yurrrets/borjomi/Schematic2/borjomi_v2/borjomi_board_v2.kicad_pcb

## KiCad design Schematic2/borjomi_v2/borjomi_board_v2.kicad_pcb (2025-08-26)

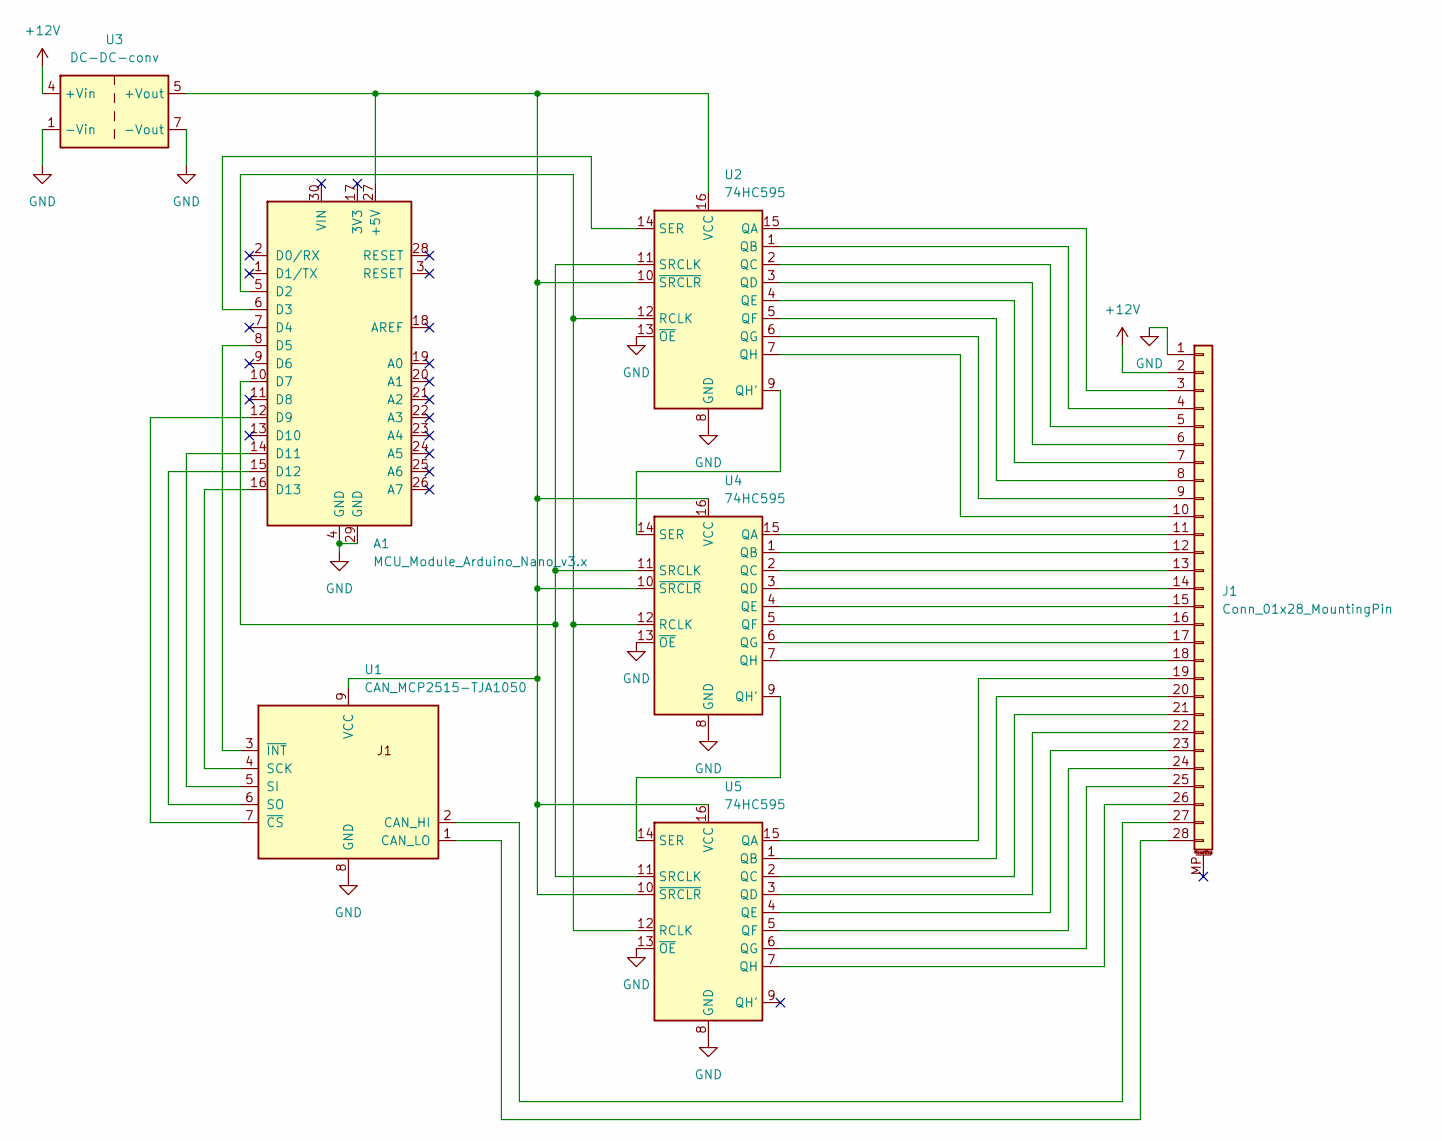
[picture p1: schematic borjomi_board_v2.kicad_sch]

Parts:
A1: MCU_Module_Arduino_Nano_v3.x; Arduino_Nano_Holes0.9
J1: Conn_01x28_MountingPin; PinHeader_1x28_P2.54mm_Vertical
U1: CAN_MCP2515-TJA1050; AOC346_MCP2515_Holes0.9
U2, U4, U5: 74HC595; DIP-16_W7.62mm
U3: DC-DC-conv; DC_DC_Step_Out

Connections:
+12V: J1.2, U3.4 (+Vin)
GND: A1.4 (GND), A1.29 (GND), J1.1, U1.8 (GND), U2.8 (GND), U2.13 (~OE), U3.1 (-Vin), U3.7 (-Vout), U4.8 (GND), U4.13 (~OE), U5.8 (GND), U5.13 (~OE)
unnamed: A1.27 (+5V), U1.9 (VCC), U2.10 (~SRCLR), U2.16 (VCC), U3.5 (+Vout), U4.10 (~SRCLR), U4.16 (VCC), U5.10 (~SRCLR), U5.16 (VCC)
unnamed: A1.5 (D2), U2.12 (RCLK), U4.12 (RCLK), U5.12 (RCLK)
unnamed: A1.6 (D3), U2.14 (SER)
unnamed: A1.8 (D5), U1.3 (~INT)
unnamed: A1.10 (D7), U2.11 (SRCLK), U4.11 (SRCLK), U5.11 (SRCLK)
unnamed: A1.12 (D9), U1.7 (~CS)
unnamed: A1.14 (D11), U1.5 (SI)
unnamed: A1.15 (D12), U1.6 (SO)
unnamed: A1.16 (D13), U1.4 (SCK)
unnamed: J1.3, U2.15 (QA)
unnamed: J1.4, U2.1 (QB)
unnamed: J1.5, U2.2 (QC)
unnamed: J1.6, U2.3 (QD)
unnamed: J1.7, U2.4 (QE)
unnamed: J1.8, U2.5 (QF)
unnamed: J1.9, U2.6 (QG)
unnamed: J1.10, U2.7 (QH)
unnamed: J1.11, U4.15 (QA)
unnamed: J1.12, U4.1 (QB)
unnamed: J1.13, U4.2 (QC)
unnamed: J1.14, U4.3 (QD)
unnamed: J1.15, U4.4 (QE)
unnamed: J1.16, U4.5 (QF)
unnamed: J1.17, U4.6 (QG)
unnamed: J1.18, U4.7 (QH)
unnamed: J1.19, U5.15 (QA)
unnamed: J1.20, U5.1 (QB)
unnamed: J1.21, U5.2 (QC)
unnamed: J1.22, U5.3 (QD)
unnamed: J1.23, U5.4 (QE)
unnamed: J1.24, U5.5 (QF)
unnamed: J1.25, U5.6 (QG)
unnamed: J1.26, U5.7 (QH)
unnamed: J1.27, U1.2 (CAN_HI)
unnamed: J1.28, U1.1 (CAN_LO)
unnamed: U2.9 (QH'), U4.14 (SER)
unnamed: U4.9 (QH'), U5.14 (SER)

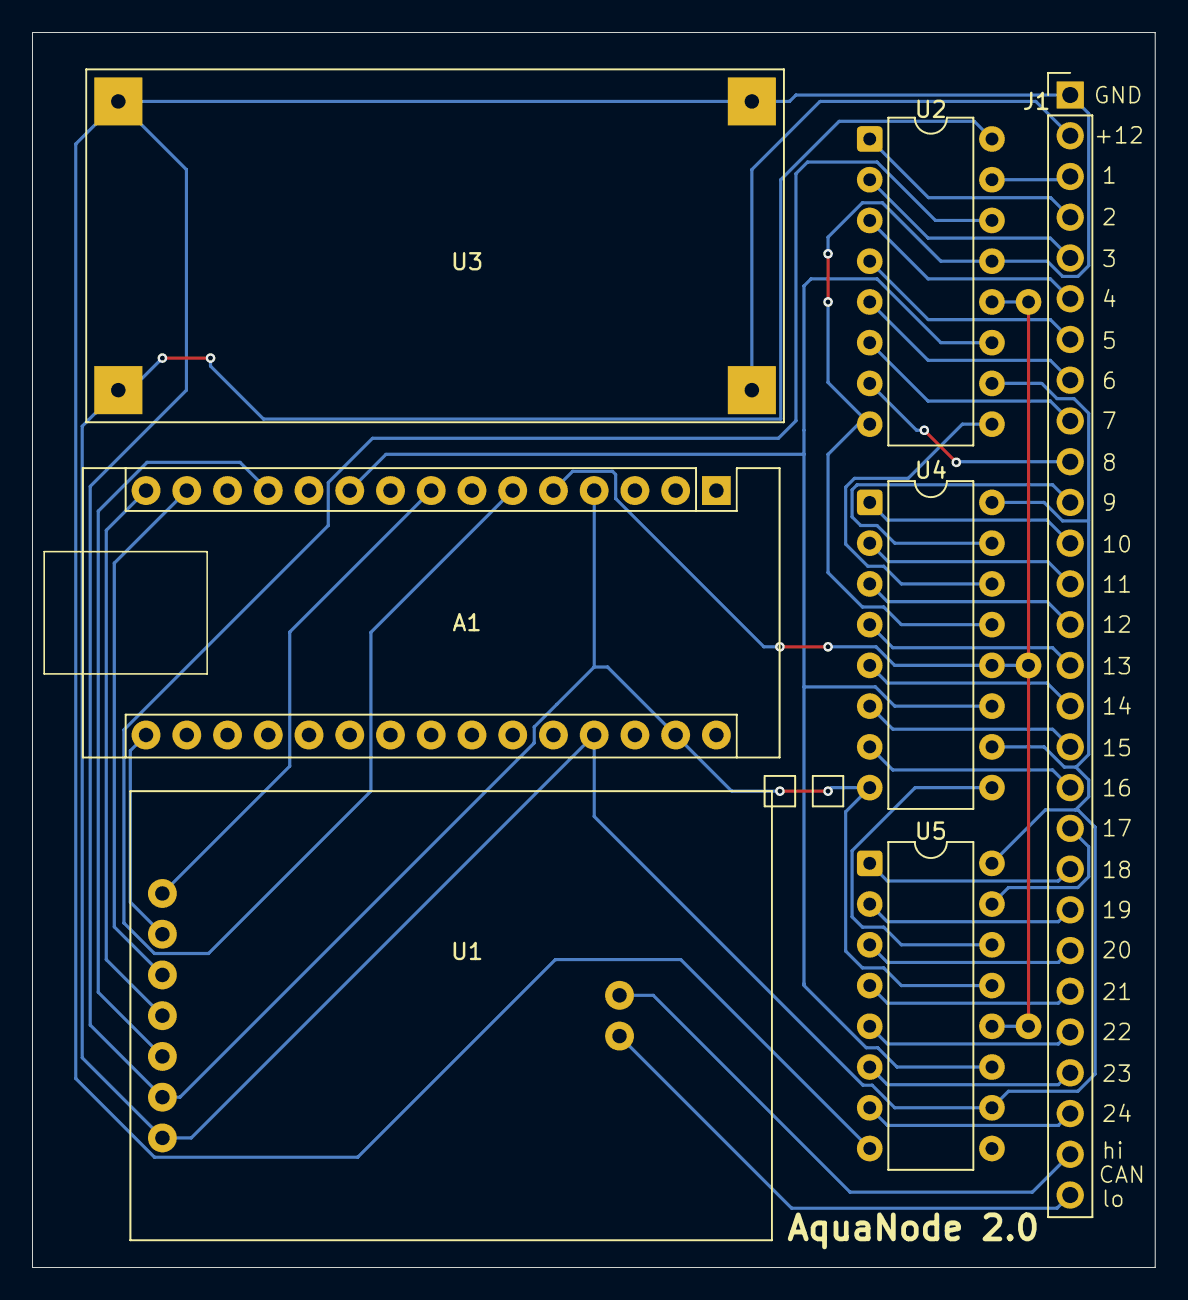
[picture p2: board borjomi_board_v2.kicad_pcb from above]

Board: 2 copper layers, 70.0 x 77.0 mm, 7 parts (0 on the bottom side), 39 nets.
