yurrrets/borjomi/Schematic/Borjomi-Main.kicad_pcb

## KiCad design Schematic/Borjomi-Main.kicad_pcb (2020-08-30)

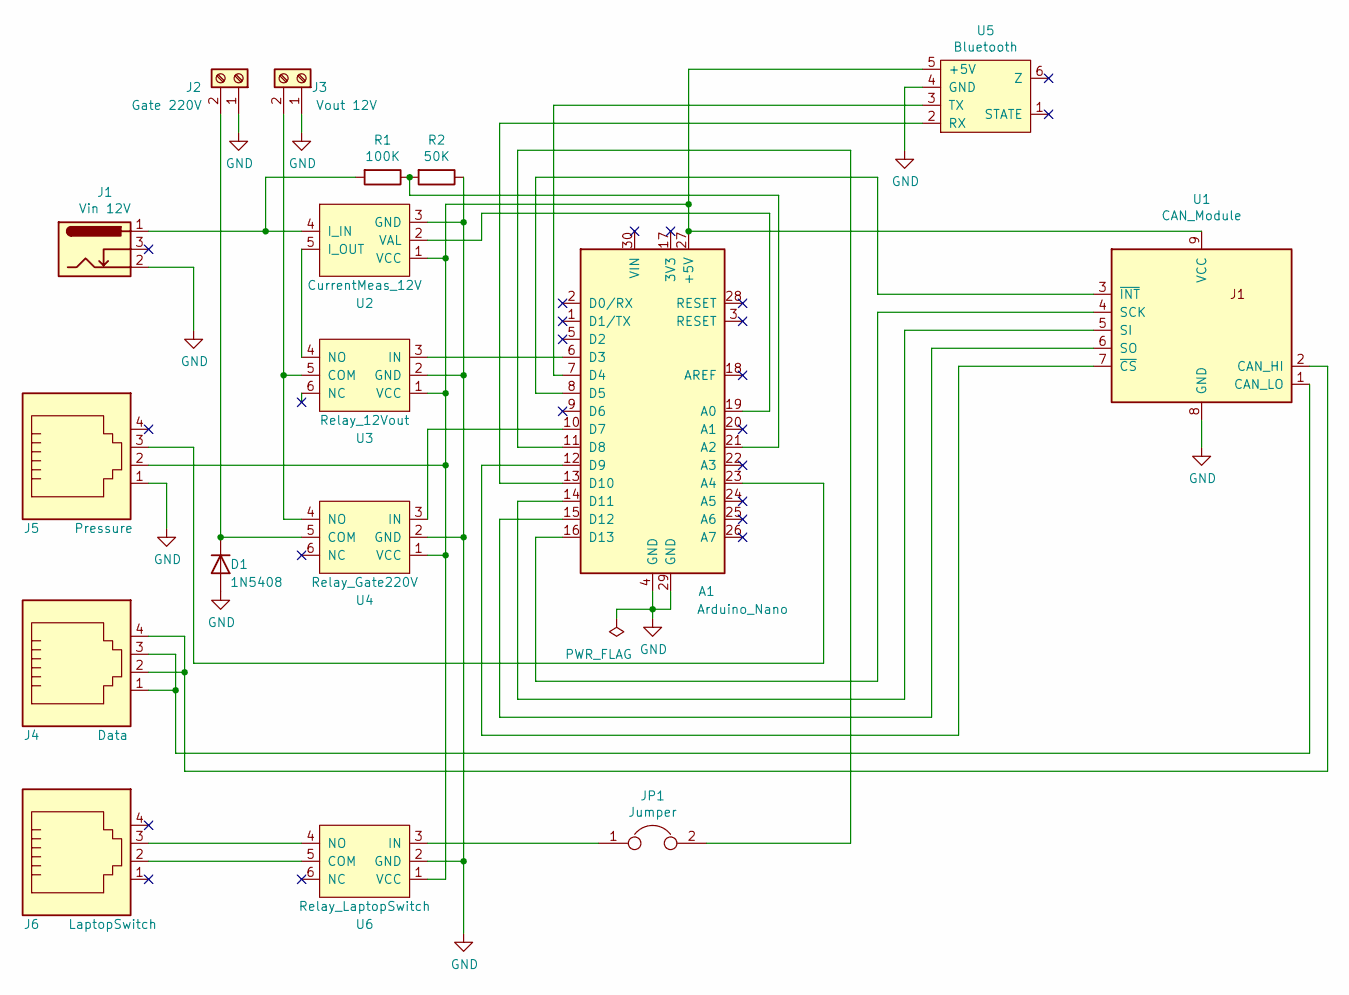
[picture p3: schematic Borjomi-Main.sch, My Scheme]

Parts:
A1: Arduino_Nano; Arduino_Nano_Holes0.9
D1: 1N5408; D_DO-27_P5.08mm_Vertical_KathodeUp
J1: Vin 12V; BarrelJack_Horizontal
J2: Gate 220V; Degson_DG301_1x02_P5.00mm_Horizontal
J3: Vout 12V; Degson_DG301_1x02_P5.00mm_Horizontal
J4: Data; RJ14_YH-57-21_5722_6P4C
J5: Pressure; RJ14_YH-57-21_5722_6P4C
J6: LaptopSwitch; RJ14_YH-57-21_5722_6P4C
JP1: Jumper; SimpleJumper_Pitch5.08mm_Drill0.7mm_2pad
R1: 100K; R_Box_L8.4mm_W2.5mm_P5.08mm
R2: 50K; R_Box_L8.4mm_W2.5mm_P5.08mm
U1: CAN_Module; AOC346_MCP2515_Holes0.9
U2: CurrentMeas_12V; ACS712
U3: Relay_12Vout; Relay_Module_1_Channel_Holes0.9
U4: Relay_Gate220V; Relay_Module_1_Channel_Holes0.9
U5: Bluetooth; HC-05
U6: Relay_LaptopSwitch; Relay_Module_1_Channel_Holes0.9

Connections:
GND: A1.4 (GND), A1.29 (GND), D1.2 (A), J1.2, J2.1, J3.1, J5.1, R2.1, U1.8 (GND), U2.3 (GND), U3.2 (GND), U4.2 (GND), U5.4 (GND), U6.2 (GND)
unnamed: A1.6 (D3), U3.3 (IN)
unnamed: A1.7 (D4), U5.3 (TX)
unnamed: A1.8 (D5), U1.3 (~INT)
unnamed: A1.10 (D7), U4.3 (IN)
unnamed: A1.11 (D8), JP1.2
unnamed: A1.12 (D9), U1.7 (~CS)
unnamed: A1.13 (D10), U5.2 (RX)
unnamed: A1.14 (D11), U1.5 (SI)
unnamed: A1.15 (D12), U1.6 (SO)
unnamed: A1.16 (D13), U1.4 (SCK)
unnamed: A1.19 (A0), U2.2 (VAL)
unnamed: A1.21 (A2), R1.1, R2.2
unnamed: A1.23 (A4), J5.3
unnamed: A1.27 (+5V), J5.2, U1.9 (VCC), U2.1 (VCC), U3.1 (VCC), U4.1 (VCC), U5.5 (+5V), U6.1 (VCC)
unnamed: D1.1 (K), J2.2, U4.5 (COM)
unnamed: J1.1, R1.2, U2.4 (I_IN)
unnamed: J3.2, U3.5 (COM), U4.4 (NO)
unnamed: J4.1, J4.3, U1.1 (CAN_LO)
unnamed: J4.2, J4.4, U1.2 (CAN_HI)
unnamed: J6.2, U6.5 (COM)
unnamed: J6.3, U6.4 (NO)
unnamed: JP1.1, U6.3 (IN)
unnamed: U2.5 (I_OUT), U3.4 (NO)

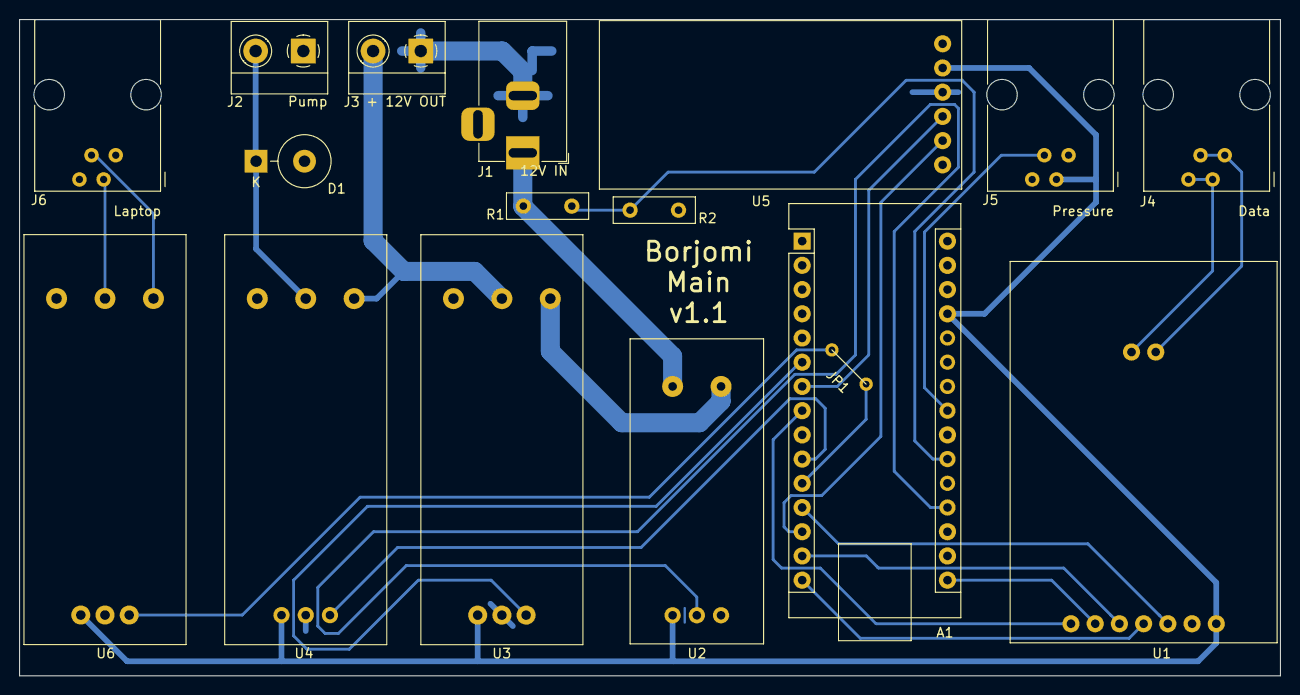
[picture p4: board Borjomi-Main.kicad_pcb from above]

Board: 2 copper layers, 132.3 x 68.8 mm, 17 parts (0 on the bottom side), 24 nets.
