yurrrets/borjomi/Schematic/Borjomi.kicad_pcb

## KiCad design Schematic/Borjomi.kicad_pcb (2019-04-21)

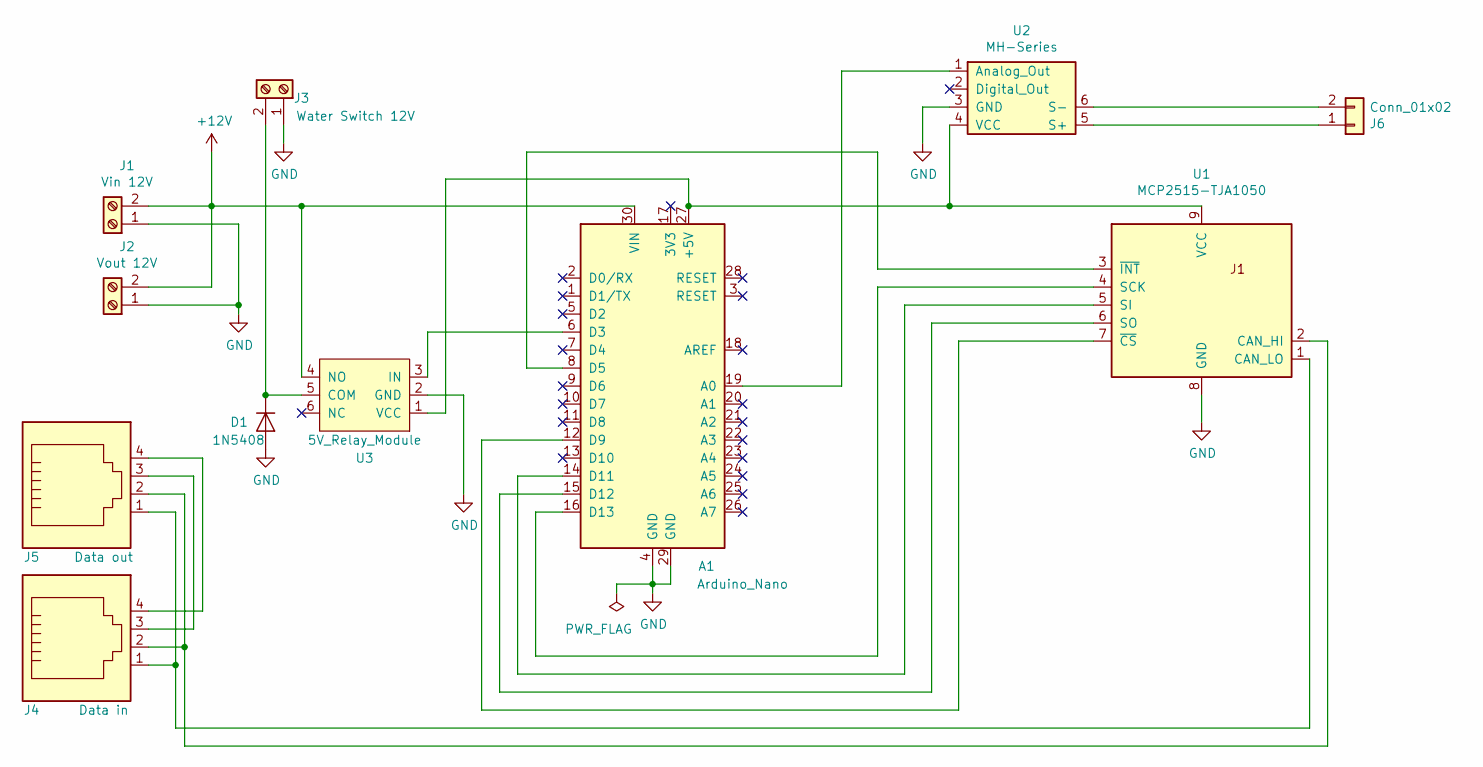
[picture p5: schematic Borjomi.sch, My Scheme]

Parts:
A1: Arduino_Nano; Arduino_Nano_Holes0.9
D1: 1N5408; D_DO-27_P5.08mm_Vertical_KathodeUp
J1: Vin 12V; Degson_DG301_1x02_P5.00mm_Horizontal
J2: Vout 12V; Degson_DG301_1x02_P5.00mm_Horizontal
J3: Water Switch 12V; Degson_DG301_1x02_P5.00mm_Horizontal
J4: Data in; RJ14_YH-57-21_5722_6P4C
J5: Data out; RJ14_YH-57-21_5722_6P4C
J6: Conn_01x02; Degson_DG301_1x02_P5.00mm_Horizontal
U1: MCP2515-TJA1050; AOC346_MCP2515_Holes0.9
U2: MH-Series; MH_Sensor_Holes0.9
U3: 5V_Relay_Module; Relay_Module_1_Channel_Holes0.9

Connections:
+12V: A1.30 (VIN), J1.2, J2.2, U3.4 (NO)
GND: A1.4 (GND), A1.29 (GND), D1.2 (A), J1.1, J2.1, J3.1, U1.8 (GND), U2.3 (GND), U3.2 (GND)
unnamed: A1.6 (D3), U3.3 (IN)
unnamed: A1.8 (D5), U1.3 (~INT)
unnamed: A1.12 (D9), U1.7 (~CS)
unnamed: A1.14 (D11), U1.5 (SI)
unnamed: A1.15 (D12), U1.6 (SO)
unnamed: A1.16 (D13), U1.4 (SCK)
unnamed: A1.19 (A0), U2.1 (Analog_Out)
unnamed: A1.27 (+5V), U1.9 (VCC), U2.4 (VCC), U3.1 (VCC)
unnamed: D1.1 (K), J3.2, U3.5 (COM)
unnamed: J4.1, J5.1, U1.1 (CAN_LO)
unnamed: J4.2, J5.2, U1.2 (CAN_HI)
unnamed: J4.3, J5.3
unnamed: J4.4, J5.4
unnamed: J6.1, U2.5 (S+)
unnamed: J6.2, U2.6 (S-)

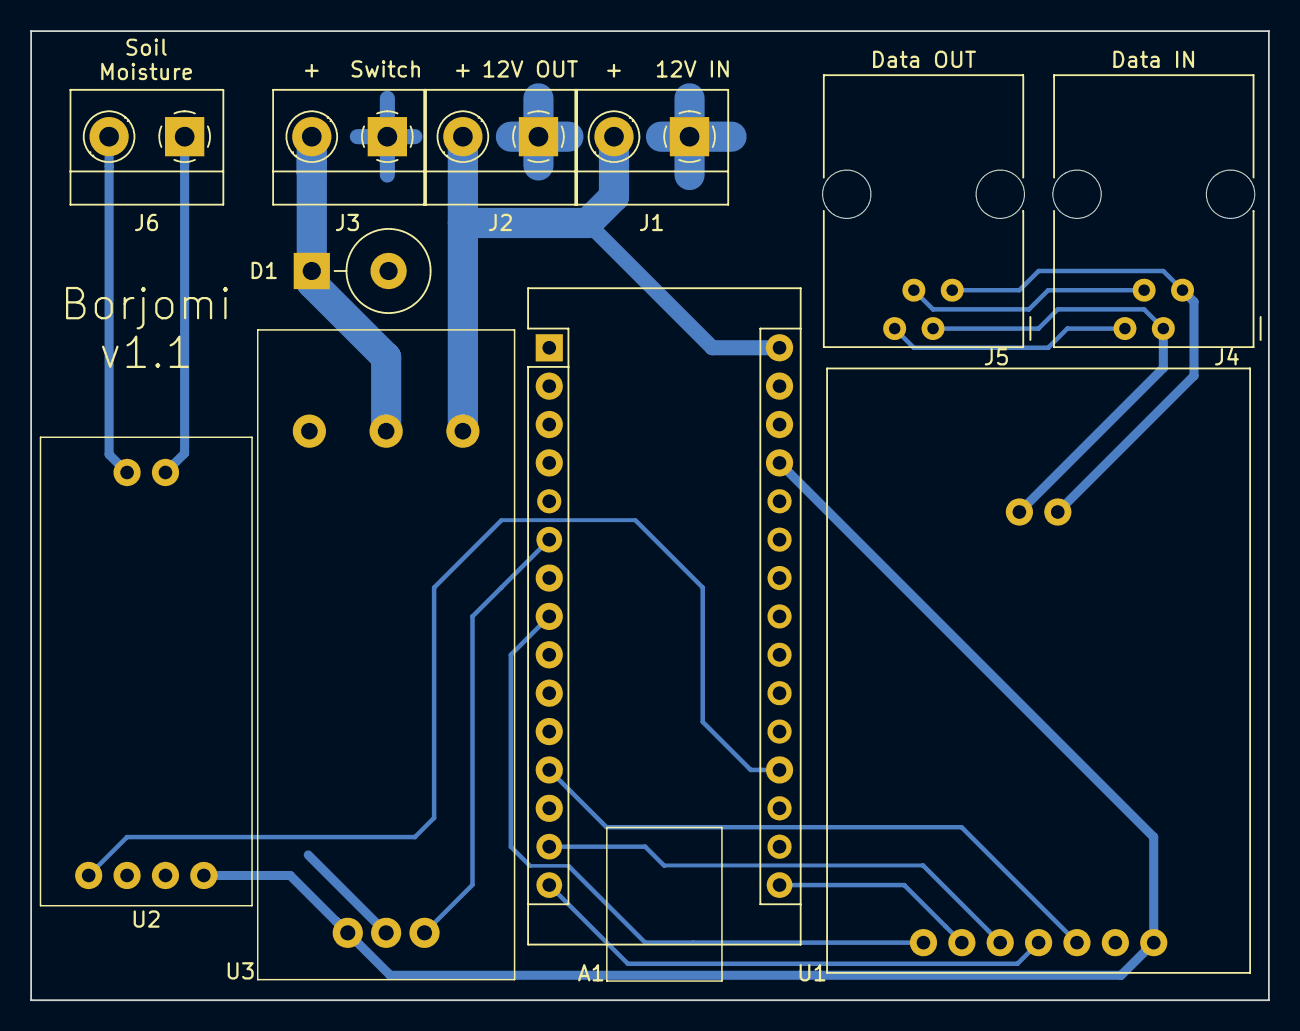
[picture p6: board Borjomi.kicad_pcb from above]

Board: 2 copper layers, 81.9 x 64.1 mm, 11 parts (0 on the bottom side), 17 nets.
