yurrrets/borjomi/Arduino/sources/common-node/src/cmd_codes.h

// Message format (8-byte message)
//   ByteNo     Description
//   0          CRC8 of next 7 bytes
//   1          Command No
//   2          Command code CMD_XXX
//   3          Command device num (pin num or ordinal device num [water switch num, soil moisture num, etc.)
//   4-7        Value


#define CMD_INVALID              (0)
#define CMD_ERROR                (0xFF)

#define CVAL_ERR_NO_ERROR        (0)
#define CVAL_ERR_INVALID_DEV_NO  (1)

/// This is the answer for most commands (except PING).
/// Keep CommandNo and CommandDevNo.
/// Value in answer depends on command type.
/// For CMD_SET_XXX is usually CVAL_ACCEPTED
#define CMD_OK                   (1)
#define CVAL_ACCEPTED            (0)

/// When send to node 0x0 (MULTICAST_NODE), this means multicast message.
/// And every slave node in this case should answer with CMD_PONG.
/// Otherwise react only if node address matches, as always.
#define CMD_PING                 (2)

/// This is the answer to ping command (CMD_PING)
/// Value of command answer is slave node's address.
#define CMD_PONG                 (3)

/// Sets state of water switch.
/// Value could be CVAL_CLOSED or CVAL_OPENED
/// Command device num is ordinal number, 0...(count(PINS_WATER_SWITCH)-1)
#define CMD_SET_WATER_SWITCH     (4)
#define CVAL_CLOSED              (0)
#define CVAL_OPENED              (1)

/// Gets current state of water switch.
/// Returned value is CVAL_CLOSED or CVAL_OPENED
/// Command device num is ordinal number, 0...(count(PINS_WATER_SWITCH)-1)
#define CMD_GET_WATER_SWITCH     (5)
//#define CVAL_CLOSING             (3)
//#define CVAL_OPENING             (4)

/// Reads soil moisture value, in range 0..1024
/// Value is relative, bigger values means that moisture is bigger.
/// Command device num is ordinal number, 0...(count(PINS_SOIL_MOISTURE)-1)
#define CMD_READ_SOIL_MOISTURE   (6)

/// Returns current version of firmware.
/// Answer is CMD_OK, and value is in format <major>.<minor>.<rev>
/// Highest 8 bits of value is <major>, next 8 bits are for <minor>, and lowest 16 bits are for <rev>
#define CMD_VERSION              (7)
#define MAKE_VERSION(mj,mn,rev)  ((((uint32_t)mj & 0xFF) << 24) | (((uint32_t)mn & 0xFF) << 16) | ((uint32_t)rev & 0xFFFF))

/// Returns capabilities of the node.
/// Answer is CMD_OK.
/// Value consist of 8 group by 4 bits.
/// Every group correspond to one of CB_XXX const.
/// Rule: CB_WATER_SWITCH == 1, and group is first 4 bits.
/// CB_SOIL_MOISTURE == 2, and group is second 4 bits. And so on.
#define CMD_CAPABILITIES         (8)

/// Reads current pressure in the system in mAtm (milli atmosphere)
/// Command device num is ordinal number, 0...(count(PINS_PRESSURE_SENSOR)-1)
#define CMD_READ_PRESSURE_SENSOR     (10)

/// Returns DC current in 12V line, in mA
/// Command device num is ordinal number, 0...(count(PINS_CURRENT_SENSOR)-1)
#define CMD_READ_CURRENT_SENSOR      (11)

/// Sets state of DC 12V line switch.
/// Value could be CVAL_OFF or CVAL_ON
/// Command device num is ordinal number, 0...(count(PINS_DC_ADAPTER_SWITCH)-1)
#define CMD_SET_DC_ADAPTER_SWITCH    (12)
#define CVAL_OFF                     (0)
#define CVAL_ON                      (1)

/// Gets current state of DC 12V line switch.
/// Returned value is CVAL_OFF or CVAL_ON
/// Command device num is ordinal number, 0...(count(PINS_DC_ADAPTER_SWITCH)-1)
#define CMD_GET_DC_ADAPTER_SWITCH    (13)

/// Returns DC voltage in 12V line, in mV
/// Command device num is ordinal number, 0...(count(PINS_VOLTAGE_SENSOR)-1)
#define CMD_READ_VOLTAGE_SENSOR      (14)

/// Sets state of pump switch.
/// Note that pump gets worked you also should set to on DC_ADAPTER_SWITCH
/// Value could be CVAL_OFF or CVAL_ON
/// Command device num is ordinal number, 0...(count(PINS_PUMP_SWITCH)-1)
#define CMD_SET_PUMP_SWITCH          (15)

/// Gets current state of pump switch.
/// Returned value is CVAL_OFF or CVAL_ON
/// Note that this value could be CVAL_ON but this doesn't mean that pump is working;
/// pump is working when both CMD_GET_PUMP_SWITCH and CMD_GET_DC_ADAPTER_SWITCH are CVAL_ON
/// Command device num is ordinal number, 0...(count(PINS_PUMP_SWITCH)-1)
#define CMD_GET_PUMP_SWITCH          (16)

#define CMD_SET_MAIN_SCENARIO        (17)
#define CMD_GET_MAIN_SCENARIO        (18)



/// Next functions should be used carefully.
/// Remember that function do not perform any checks.
/// However, pins 0,1 are usually used as RX,TX pin on built-in COM port.
/// Pins 2,9,11,12,13 are used for SPI bus for CAN module.
/// Pin 3 is used for Water Switch.
/// Avoid using this pins directly with next functions.


/// Calls analogWrite Arduino function. Uses commandPin part of message.
/// Answers with CMD_OK, value equals to value parameter of input messge.
#define CMD_ANALOG_WRITE         (32)

/// Reads the value of analog input pin. Uses commandPin part of message.
/// Just calls analogRead Arduino function, and return the value.
#define CMD_ANALOG_READ          (33)

/// Calls digitalWrite Arduino function. Uses commandPin part of message.
/// Answers with CMD_OK, value equals to value parameter of input messge.
#define CMD_DIGITAL_WRITE        (34)

/// Calls digitalRead Arduino function. Uses commandPin part of message.
/// Answers with CMD_OK, value equals to result of digitalRead call.
#define CMD_DIGITAL_READ         (35)

/// Calls pinMode Arduino function. Uses commandPin part of message.
/// Answers with CMD_OK, value equals to CVAL_ACCEPTED.
#define CMD_DIGITAL_PIN_MODE     (36)
