yurrrets/borjomi/Arduino/tests/arduino-mock/Arduino.h

#pragma once

#include <cstdint>
#include "HardwareSerial.h"

#define HIGH 0x1
#define LOW  0x0

#define INPUT 0x0
#define OUTPUT 0x1
#define INPUT_PULLUP 0x2

#define F(str) str

typedef uint8_t byte;

unsigned long millis(void);
unsigned long micros(void);
void delay(unsigned long ms);
void delayMicroseconds(unsigned int us);

void pinMode(uint8_t pin, uint8_t mode);
void digitalWrite(uint8_t pin, uint8_t val);
int digitalRead(uint8_t pin);
int analogRead(uint8_t pin);
void analogReference(uint8_t mode);
void analogWrite(uint8_t pin, int val);
