yurrrets/borjomi/Arduino/tests/arduino-mock/TemplateTools.h

template <class... Args>
struct template_concat;

template <template <class...> class T, class... Args1, class... Args2, typename... Remaining>
struct template_concat<T<Args1...>, T<Args2...>, Remaining...> {
    using type = typename template_concat<T<Args1..., Args2...>, Remaining...>::type;
};

template <template <class...> class T, class... Args1>
struct template_concat<T<Args1...>> {
    using type = T<Args1...>;
};

template <class... Args>
using template_concat_t = typename template_concat<Args...>::type;


// helper type for the visitor #4
template<class... Ts>
struct overloaded : Ts... { using Ts::operator()...; };
// explicit deduction guide (not needed as of C++20)
template<class... Ts>
overloaded(Ts...) -> overloaded<Ts...>;


template<typename T, typename... Ts>
std::ostream& operator<<(std::ostream& os, const std::variant<T, Ts...>& v)
{
    std::visit([&os](auto&& arg) {
        os << arg;
    }, v);
    return os;
}
