yurrrets/borjomi/(commit log)

2018-09-18 add Arduino folder
2018-09-29 Add Schematics folder
    [Borjomi.kicad_pcb, Borjomi.sch]
2018-11-03 More implementation (VERSION cmd), bug fixing, improvements
    [bt_commands.cpp, bt_commands.h, cmd_handler.cpp, main.cpp]
2018-11-03 Turn off debug prints, soil moisture value inversing
2018-11-25 Add doc folder; add electric scheme near water pump
2019-04-04 Add relay module (scheme, lib, footprint)
    [Borjomi.sch]
2019-04-05 Add footprints for components; add pcb basic
    [Borjomi.sch]
2019-04-06 Update footprints (place pads in right order)
    [Borjomi.kicad_pcb, Borjomi.sch]
2019-04-08 Pcb v1.0 + gerber files
    [Borjomi.kicad_pcb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]
2019-04-21 PCB v1.1 + gerber
    [Borjomi-Board.gm1, Borjomi-Bot.gbl, Borjomi-BotMask.gbs, Borjomi-NPTH.drl, Borjomi-PTH.drl, Borjomi-TopMask.gts, Borjomi-TopSilk.gto, Borjomi-v1_1.gbl]
2019-06-13 Add "borjomi-main" board
    1) Scematics (full)
    2) PCB layout (partly done)
    [Borjomi-Main.kicad_pcb, Borjomi-Main.sch]
2019-06-13 Borjomi-main: almost final pcb
    [Borjomi-Main.kicad_pcb]
2019-06-14 Borjomi-main PCB v1.0
    [Borjomi-Main.kicad_pcb]
2019-06-14 Fix few bugs
    [Borjomi-Main.kicad_pcb]
2019-06-14 Generate gerber files
    [Borjomi-Main-B_Cu.gbl, Borjomi-Main-B_Mask.gbs, Borjomi-Main-Edge_Cuts.gm1, Borjomi-Main-F_SilkS.gto, Borjomi-Main-NPTH.drl, Borjomi-Main-PTH.drl]
2019-06-18 Update schematics/pcb to use barrel_connector as 12V IN
    [Borjomi-Main.kicad_pcb, Borjomi-Main.sch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]
2019-06-20 Rename gerber/drill files; add .doc file for order
    [Borjomi-Main-v1_0-B_Cu.gbl, Borjomi-Main-v1_0-B_Mask.gbs, Borjomi-Main-v1_0-Edge_Cuts.gm1, Borjomi-Main-v1_0-F_SilkS.gto, Borjomi-Main-v1_0-NPTH.drl, Borjomi-Main-v1_0-PTH.drl]
2019-08-04 v1.1. Fix bug with voltage divider
    Also update gerber/drill files
    [Borjomi-Main.kicad_pcb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]
2019-08-08 Fix build and assign correct pin numbers (in master node)
    [bt_commands.cpp, cmd_handler.cpp, main.cpp]
2019-08-08 Update pcb for Borjomi-main
    [Borjomi-Main.kicad_pcb]
2019-08-08 Add full support of commands for master node
    Also bugfix and mini refactoring
    [bt_commands.cpp, bt_commands.h, cmd_handler.cpp, main.cpp]
2019-09-17 Add serial device; add functionality for buttons
2020-01-20 Add borjomi-server2 (web socket)
2020-03-30 Add basic functions to work with Arduino module
2020-04-09 Implement Arduino's ping and version functions
2020-04-18 Server: Queue added while work with Arduino SerialPort
2020-05-02 Implement all arduino functions on server side
    Also calls on client, and small bugfixes
2020-06-27 Make sample-configs and ignore real local configs
2020-08-30 Board Borjomi-Main v1.1 with Gerber/Drill files
    [Borjomi-Main.kicad_pcb, Borjomi-Main.sch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]
2020-10-09 Connect DC Adapter to Pin 6
    Original pin 3 breaks work of SPI bus
2021-07-03 Update master-node functionality
    Turn off PcStart module, add check for DcAdapter voltage
2021-07-03 Update Server to new HW config
    Connection using Arduino rs232 chip
2021-07-21 Update WaterScheme with current node config
2021-07-21 move low-level arduino funcs to separate module
2021-09-02 Split arduino funcs and service handlers
2021-09-15 Change range for DC voltage. For now master node can't detect voltage enough precise
2024-01-02 replace Makefiles with cmake builds; add build.sh script
    [bt_commands.cpp, bt_commands.h, button.cpp, button.h, can_commands.cpp, can_commands.h, can_message.h, cap_implementation.cpp]
2024-01-02 fix some compiler warnings
    [cmd_handler.cpp]
2024-02-04 Allow c++17. Fix nano board configs
2024-02-18 More correct command processing in can_commands
    Also apply clang formatting to can_commands, and add clang-format file
    [can_commands.cpp]
2024-02-18 Add basic start/stop scenario by button press
2024-02-18 Use lib-lcd for showing current state
2024-03-03 Fix ScenarioRunner. Add unit tests for ScenarioRunner
    Add infastructure for supporting Arduino simulations. Change master-node
    and common-node sources to be unit testable and easy mockable. Add
    gtest/gmock repo as submodule. Write basic unit tests for Arduino
    Simulations and ScenarioRunner.
    [Arduino.cpp, Arduino.h, ArduinoSims.cpp, ArduinoSims.h, CanBusSims.cpp, CanBusSims.h, GmockMatchers.h]
2024-03-08 Add SPI transfer iface to LCD screen
2024-03-20 Scenarios run bugs fixed. Add store/read main scenario cmds.
    Added command for storing and reading main scenario. Deserialize now
    parses all until new line character.
    Added reaction on error during sending over CAN bus. Crc8 calcs extended
    to calc up to 65535 bytes data length. To CrcPartial added compile-time
    checks. UpdateCrc and CheckCrc moved to separate functions.
    Tests improved, two more tests added (when error happens on sending over
    CAN bus). Also logs now works in tests also, with printing to stdout.
    [CanBusSims.cpp, CanBusSims.h, GmockMatchers.h, Print.h, Stream.cpp]
2024-03-23 Replace bool isRunning with State. Make UI more informative
    [main.cpp, scenarios.cpp, scenarios.h, scenarios_tests.cpp]
2025-06-10 AquaNode 2.0 schematics/pcb (borjomi 2.0)
2025-08-26 Add basic support for few board revisions. Implement SlaveNode rev2 (AquaNode 2.0 board)
2025-08-26 Fix 595 clock connection - from D13 used in SPI to prev unused D7
